DominikEminger/BackflipBasti/Backflip_Basti_Anzeigesystem_Schaltplan.docx

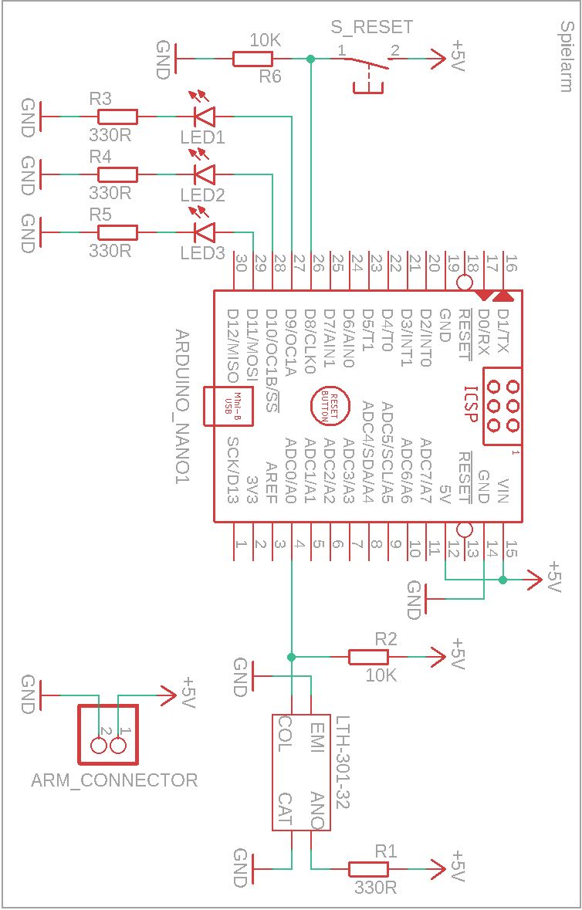
[picture p41: figure]
