DominikEminger/BackflipBasti/Backflip_Basti_Motorsteuerung_Schaltplan.docx

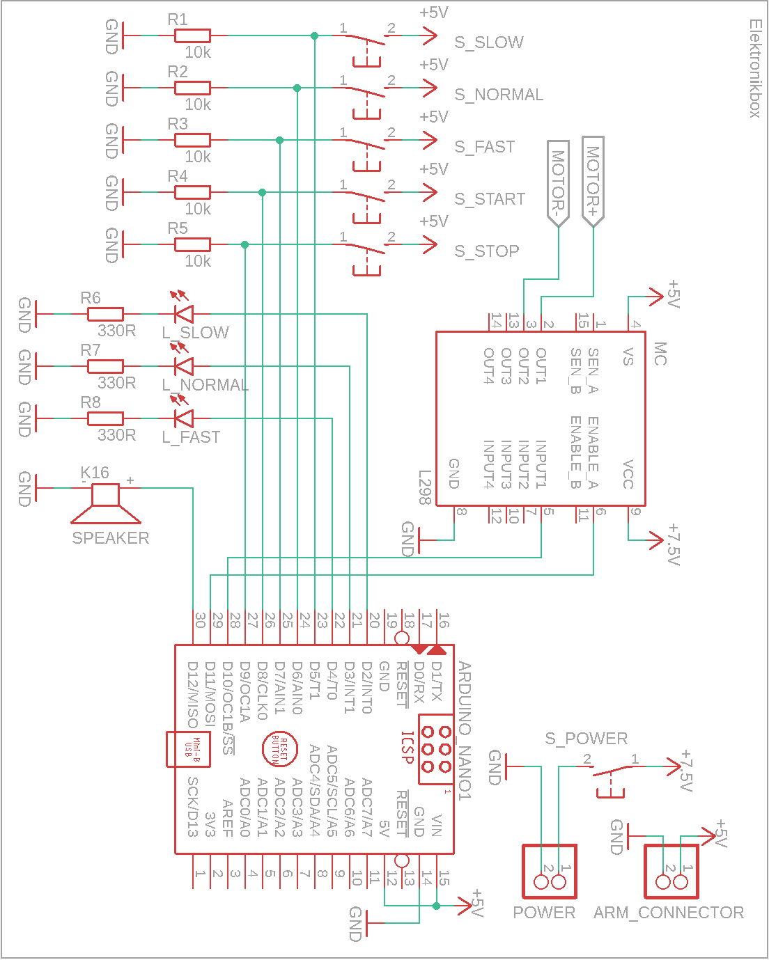
[picture p42: figure]
