DominikEminger/BackflipBasti/Backflip_Basti_Anzeigesystemprogramm.docx

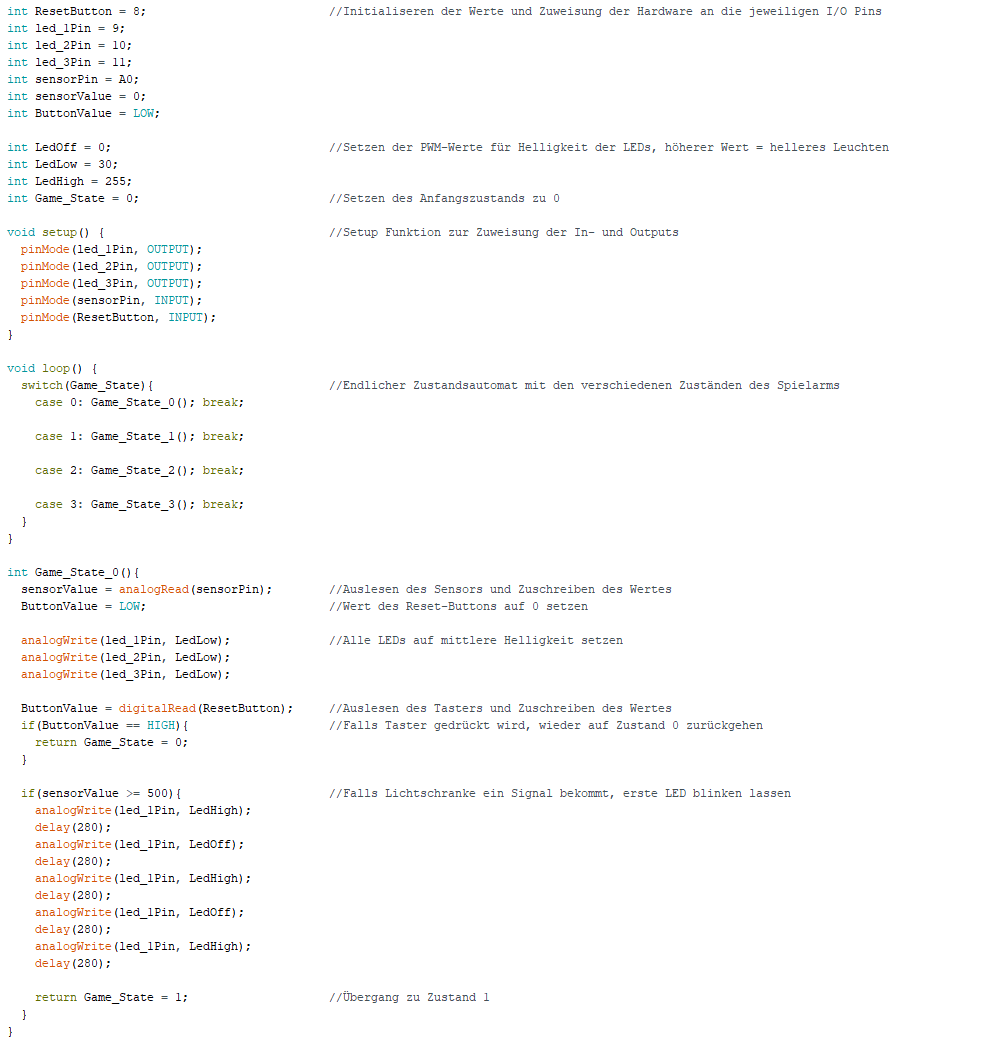
[picture p43: figure]
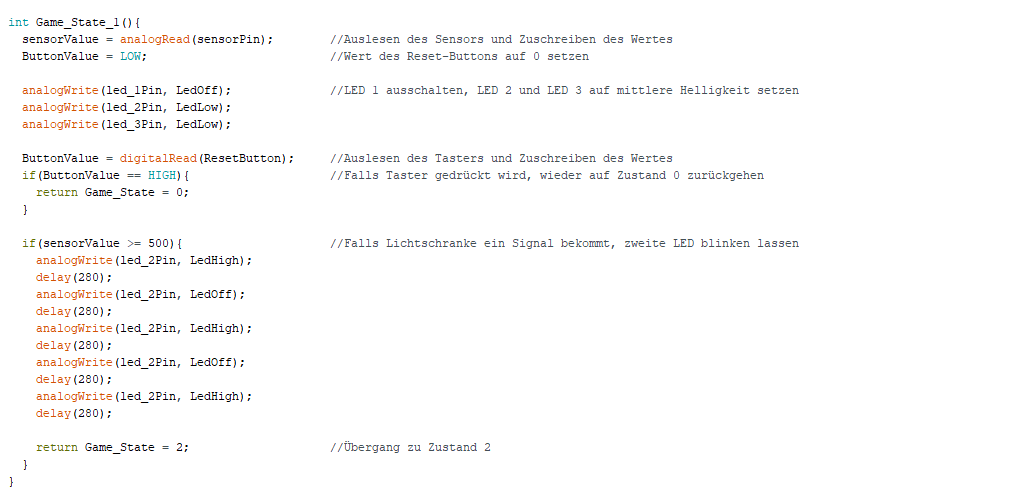
[picture p44: figure]
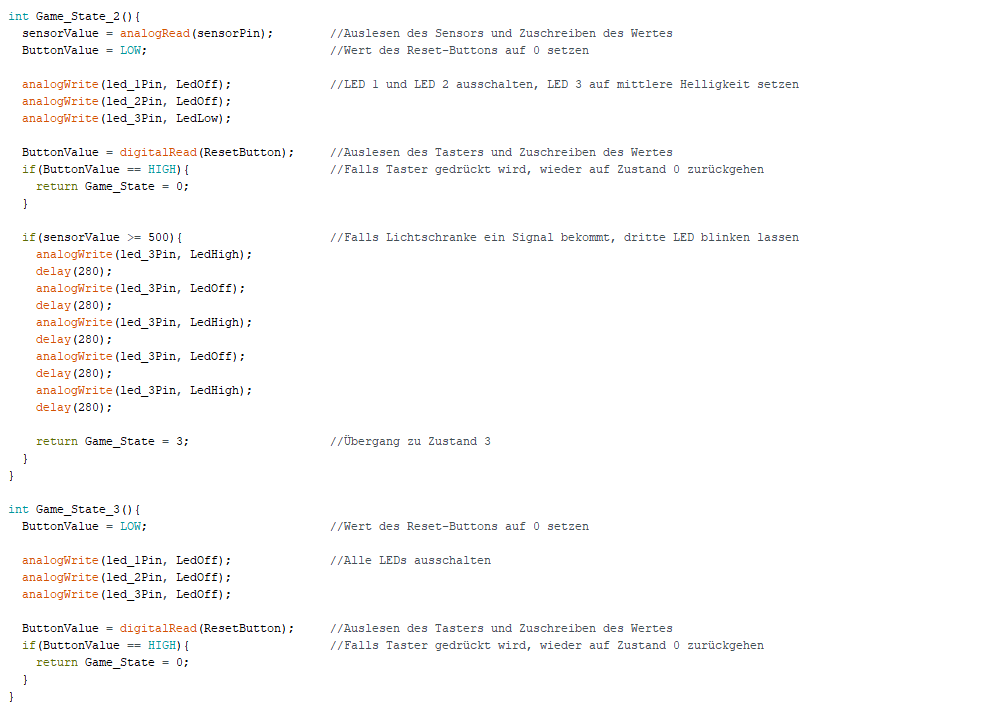
[picture p45: figure]
