DominikEminger/BackflipBasti/Backflip_Basti_Motorsteuerungsprogramm.docx

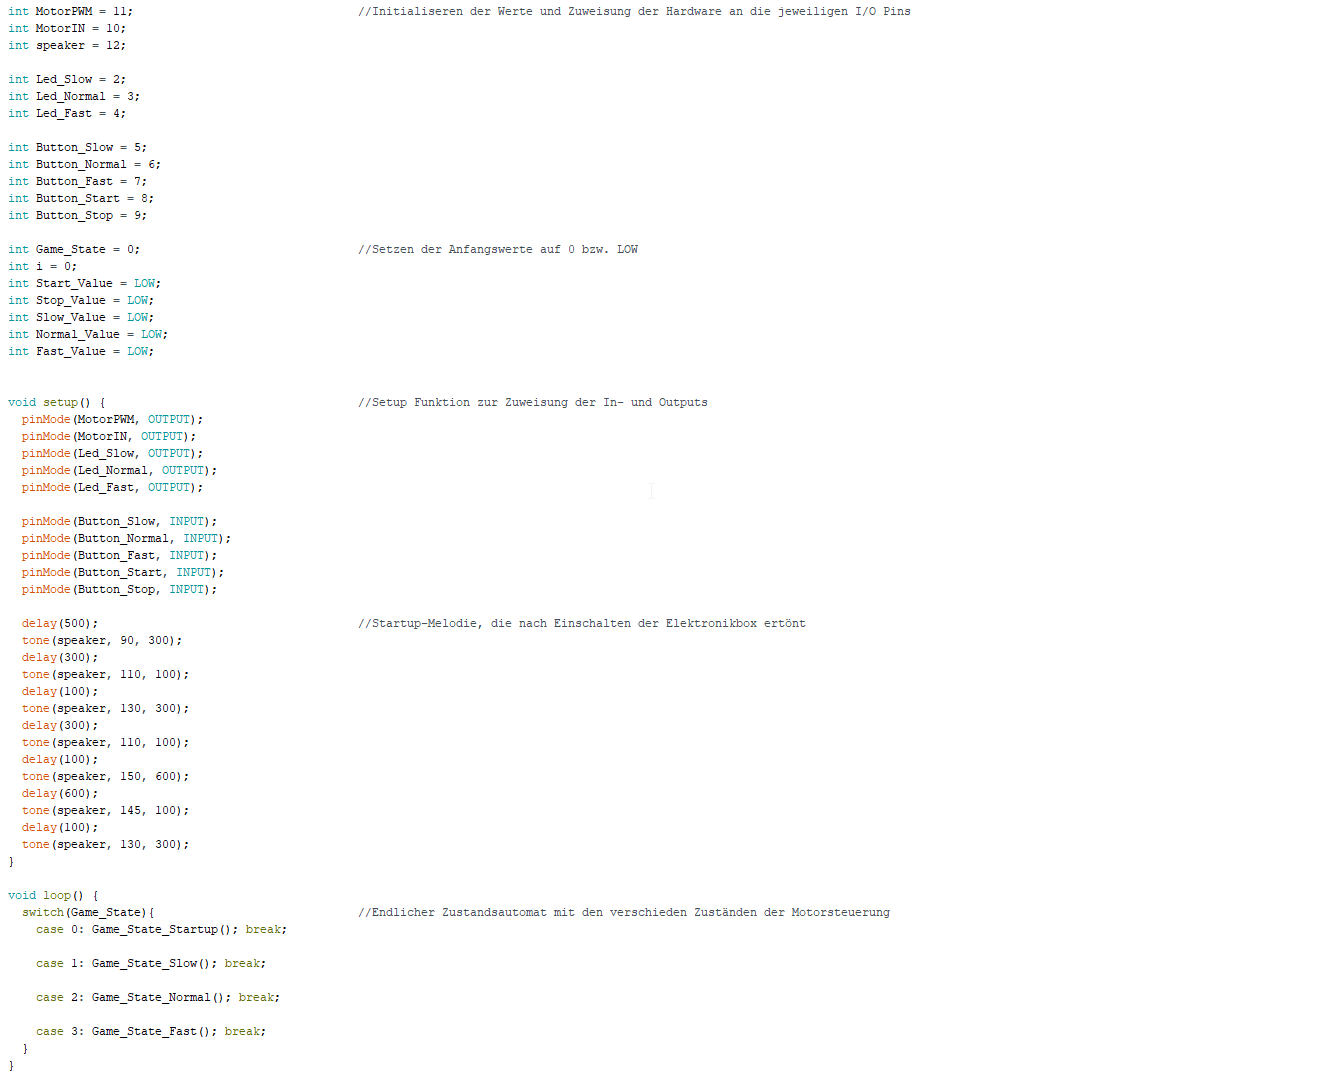
[picture p46: figure]
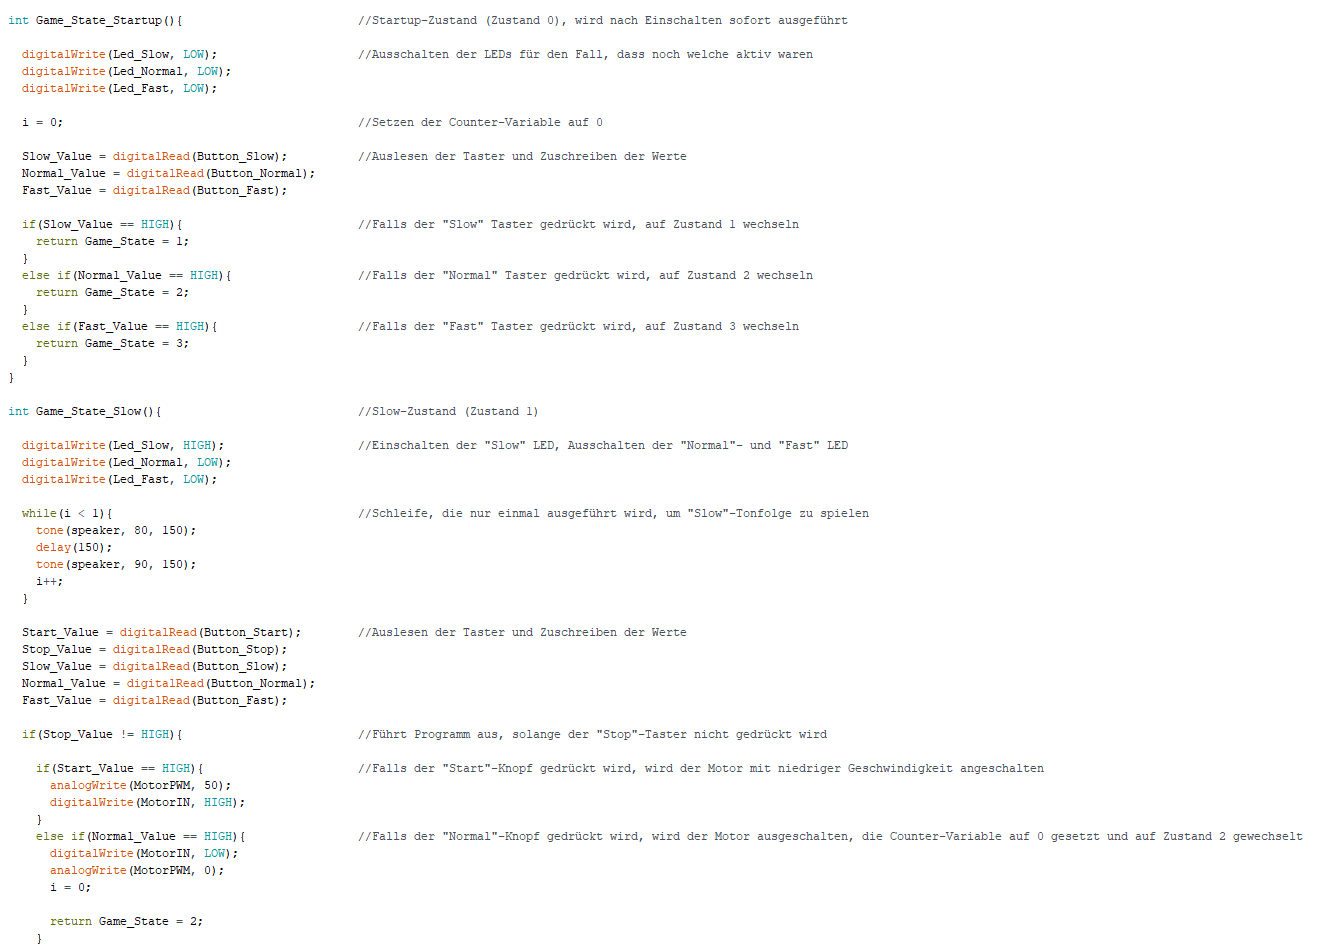
[picture p47: figure]
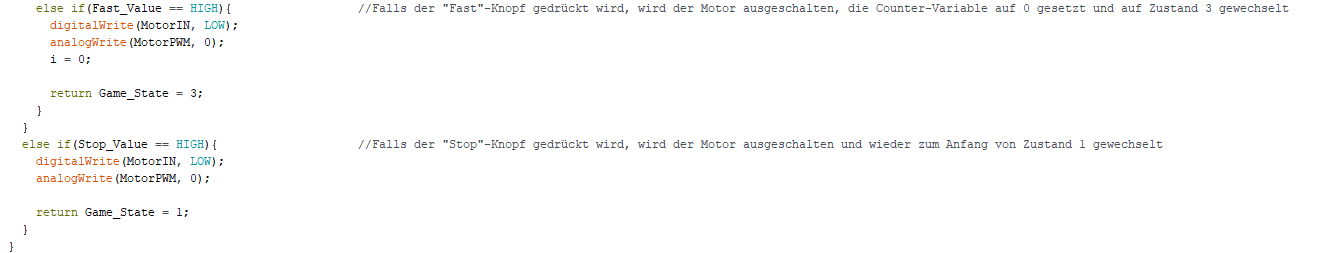
[picture p48: figure]
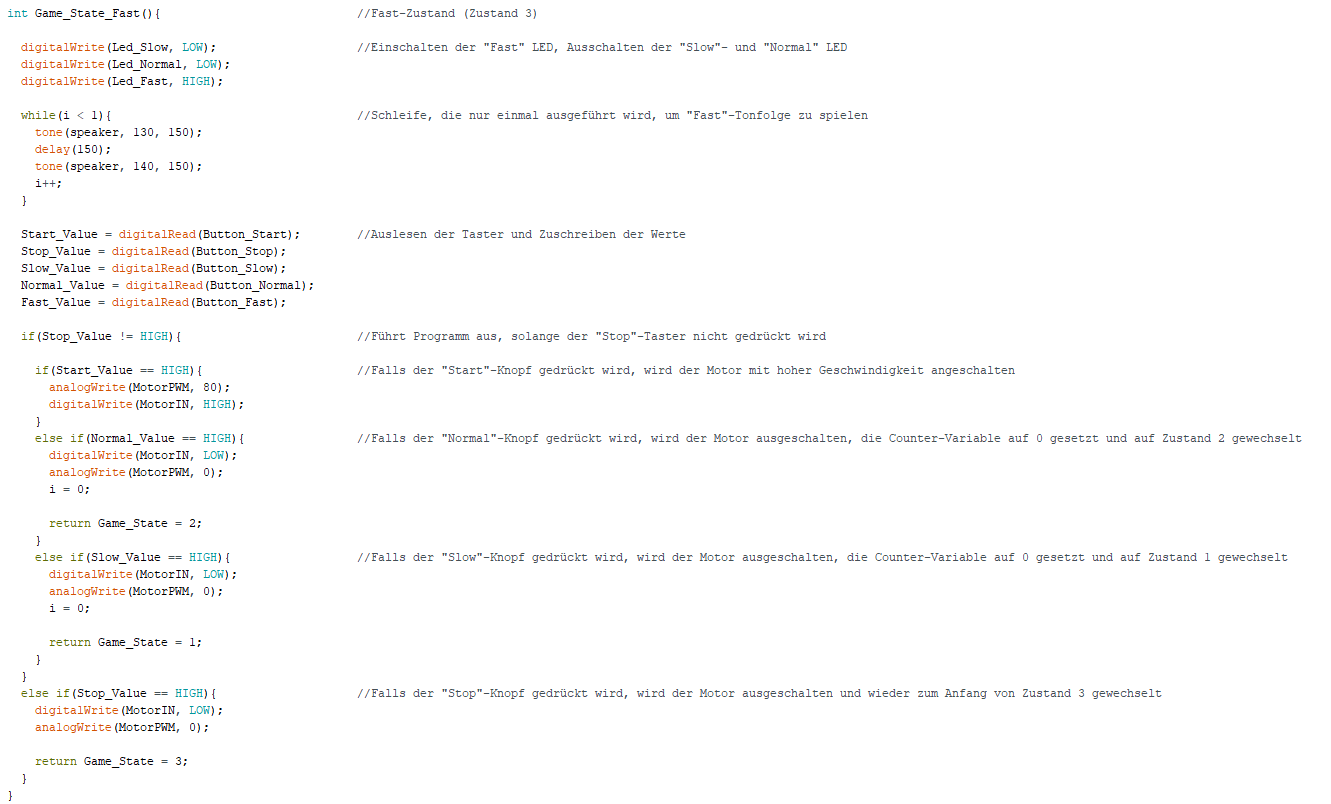
[picture p49: figure]
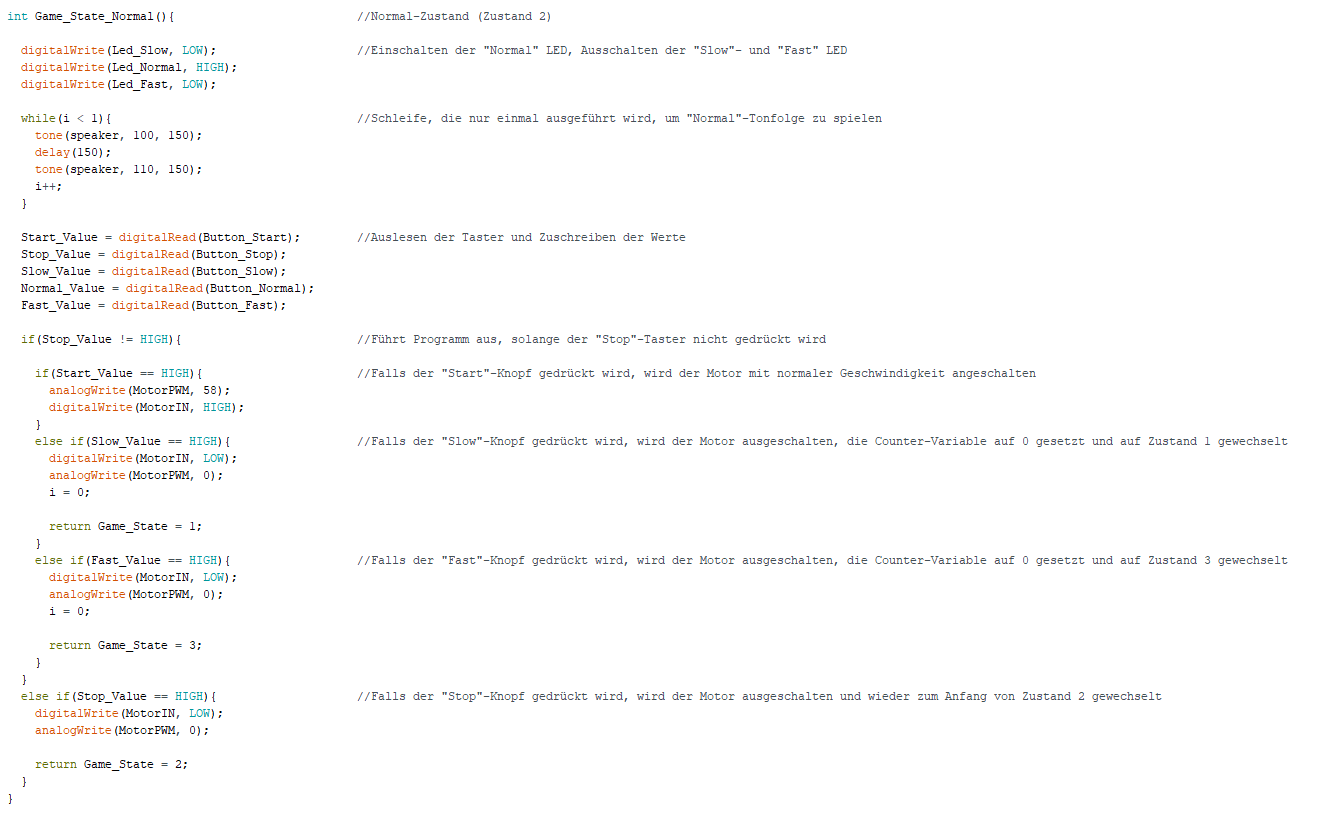
[picture p50: figure]
