DominikEminger/BackflipBasti/datenblatt-1666921-barthelme-led-sortiment-rot-rund-5-mm-800-mcd-35-20-ma-2-v.pdf

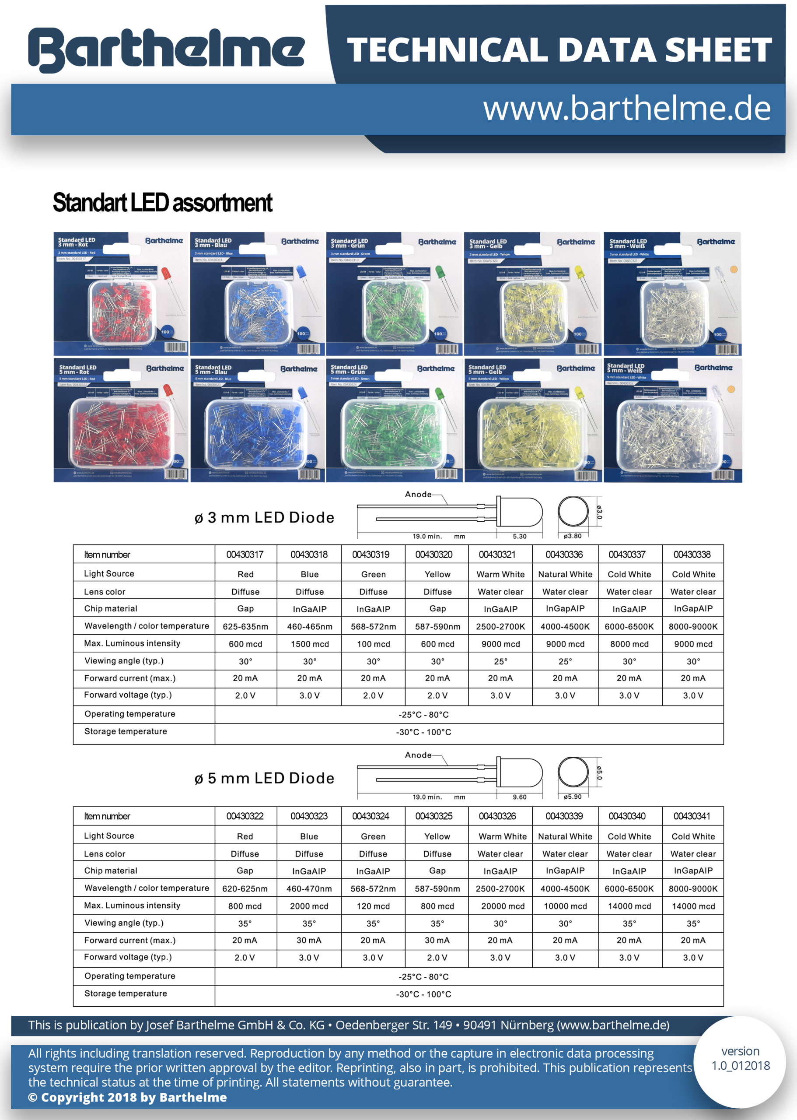
[picture p51: page 1]
