DominikEminger/BackflipBasti/rahmen_v2.stl

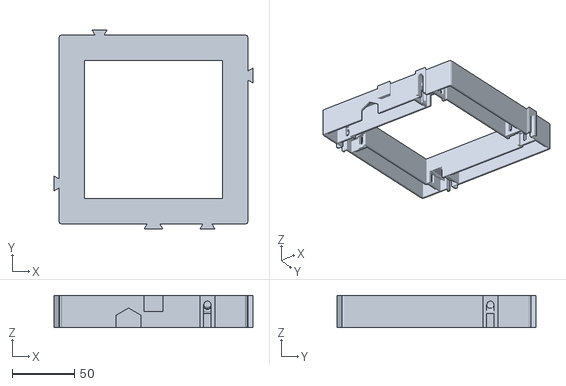
[picture p52: CAD file, 2021-03-22]
rahmen_v2.stl
159.5 x 159.5 x 26.0
