DominikEminger/BackflipBasti/box_deckel_v2.stl

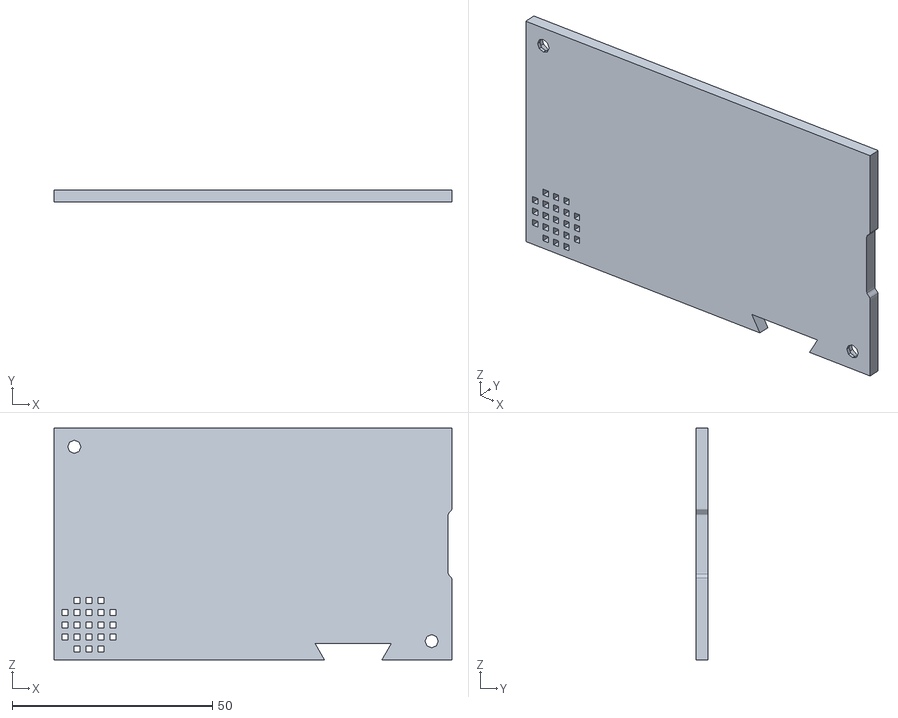
[picture p53: CAD file, 2021-03-22]
box_deckel_v2.stl
99.3 x 3.00 x 57.8
