DominikEminger/BackflipBasti/elektronikbox_v1.stl

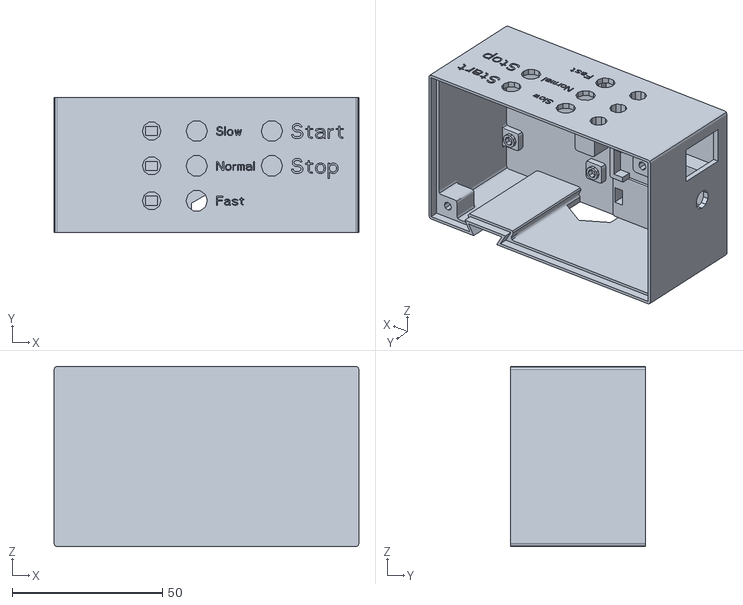
[picture p54: CAD file, 2021-03-22]
elektronikbox_v1.stl
101.5 x 45.0 x 60.0
