DominikEminger/BackflipBasti/Schaltplan_Arm.sch

## EAGLE design Schaltplan_Arm.sch (2021-03-22)

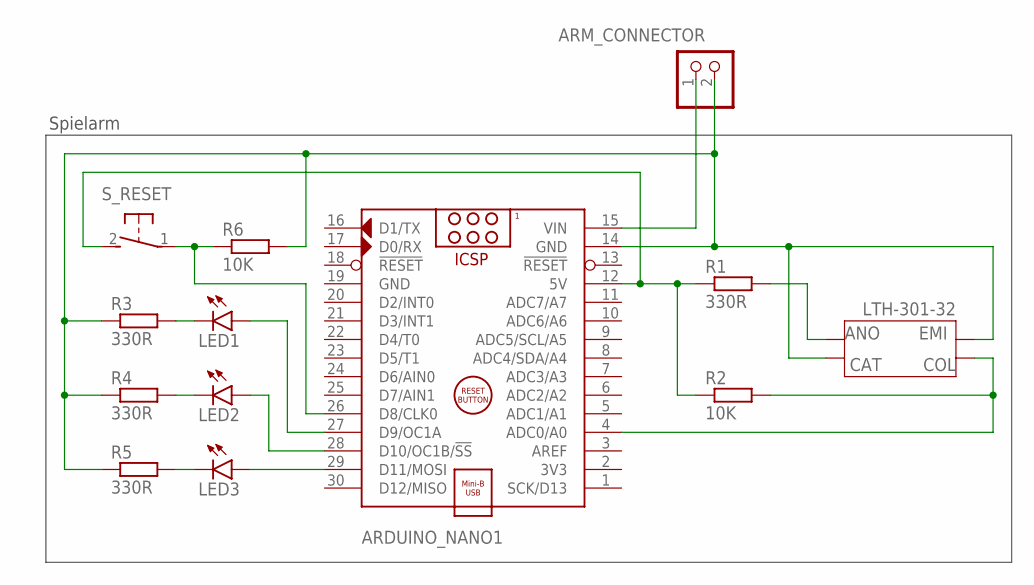
[picture p55: schematic Schaltplan_Arm.sch]

Parts:
ARDUINO_NANO1: ARDUINO_NANO
ARM_CONNECTOR: PINHD-1X2; 1X02
LED1, LED2, LED3: LAP4-BOTTOM; P47F-BOTTOM
R1, R3, R4, R5: 330R; 0204V
R2, R6: 10K; 0204V
S_RESET: 31-XX; B3F-31XX

Connections:
unnamed: ARDUINO_NANO1.15 (VIN), ARM_CONNECTOR.1
unnamed: ARDUINO_NANO1.14 (GND), ARM_CONNECTOR.2, R3.1, R4.1, R5.1, R6.2
unnamed: ARDUINO_NANO1.12 (5V), R1.1, R2.1, S_RESET.2 (S)
unnamed: ARDUINO_NANO1.29 (D11/MOSI), LED3.A
unnamed: ARDUINO_NANO1.28 (D10/OC1B/!SS), LED2.A
unnamed: ARDUINO_NANO1.4 (ADC0/A0), R2.2
unnamed: ARDUINO_NANO1.27 (D9/OC1A), LED1.A
unnamed: LED1.C, R3.2
unnamed: LED2.C, R4.2
unnamed: LED3.C, R5.2
unnamed: ARDUINO_NANO1.26 (D8/CLK0), R6.1, S_RESET.1

Notes on the sheet:
ANO
CAT
COL
EMI
LTH-301-32
Spielarm
