DominikEminger/BackflipBasti/Schaltplan_MC_V3.sch

## EAGLE design Schaltplan_MC_V3.sch (2021-03-22)

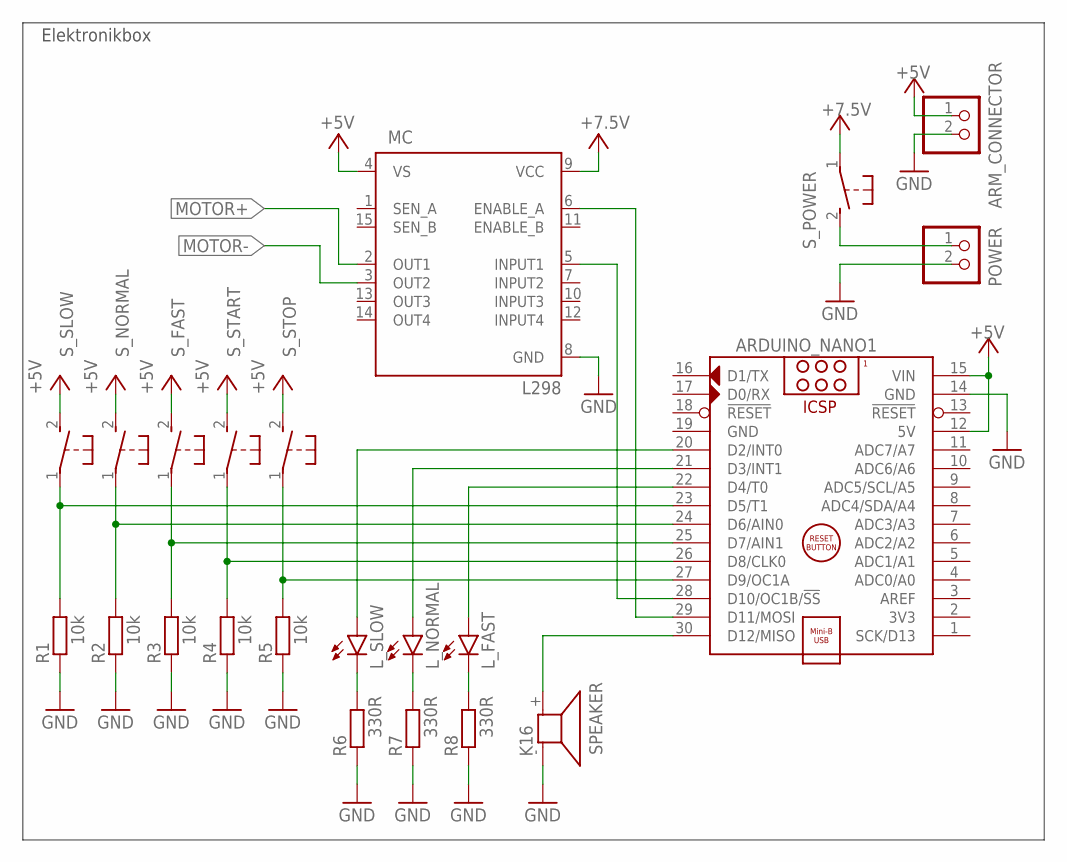
[picture p56: schematic Schaltplan_MC_V3.sch]

Parts:
ARDUINO_NANO1: ARDUINO_NANO
ARM_CONNECTOR: PINHD-1X2; 1X02
L_FAST: LAP4-BOTTOM; P47F-BOTTOM
L_NORMAL: LAP4-BOTTOM; P47F-BOTTOM
L_SLOW: LAP4-BOTTOM; P47F-BOTTOM
MC: L298; MULTIWATT-15
POWER: PINHD-1X2; 1X02
R1, R2, R3, R4, R5: 10k; 0204/5
R6, R7, R8: 330R; 0204/5
SPEAKER: K16; AL11P
S_FAST: 31-XX; B3F-31XX
S_NORMAL: 31-XX; B3F-31XX
S_POWER: 31-XX; B3F-31XX
S_SLOW: 31-XX; B3F-31XX
S_START: 31-XX; B3F-31XX
S_STOP: 31-XX; B3F-31XX

Connections:
+5V: ARDUINO_NANO1.12 (5V), ARDUINO_NANO1.15 (VIN), ARM_CONNECTOR.1, MC.4 (VS), MC.9 (VCC), S_FAST.2 (S), S_NORMAL.2 (S), S_POWER.1, S_SLOW.2 (S), S_START.2 (S), S_STOP.2 (S)
GND: ARDUINO_NANO1.14 (GND), ARM_CONNECTOR.2, MC.8 (GND), POWER.2, R1.1, R2.1, R3.1, R4.1, R5.1, R6.2, R7.2, R8.2, SPEAKER.- (1)
L_SLOW: L_SLOW.C, R6.1
MOTOR+: MC.2 (OUT1)
MOTOR-: MC.3 (OUT2)
unnamed: ARDUINO_NANO1.29 (D11/MOSI), MC.6 (ENABLE_A)
unnamed: ARDUINO_NANO1.28 (D10/OC1B/!SS), MC.5 (INPUT1)
unnamed: ARDUINO_NANO1.23 (D5/T1), R1.2, S_SLOW.1
unnamed: ARDUINO_NANO1.24 (D6/AIN0), R2.2, S_NORMAL.1
unnamed: ARDUINO_NANO1.25 (D7/AIN1), R3.2, S_FAST.1
unnamed: ARDUINO_NANO1.26 (D8/CLK0), R4.2, S_START.1
unnamed: ARDUINO_NANO1.27 (D9/OC1A), R5.2, S_STOP.1
unnamed: POWER.1, S_POWER.2 (S)
unnamed: ARDUINO_NANO1.22 (D4/T0), L_FAST.A
unnamed: L_NORMAL.C, R7.1
unnamed: ARDUINO_NANO1.30 (D12/MISO), SPEAKER.+ (2)
unnamed: ARDUINO_NANO1.21 (D3/INT1), L_NORMAL.A
unnamed: L_FAST.C, R8.1
unnamed: ARDUINO_NANO1.20 (D2/INT0), L_SLOW.A

Notes on the sheet:
Elektronikbox
